ptan101/KiCad/7.0/3dmodels/Arduino_Modules/LCD TFT ILI9225 Module v4.step

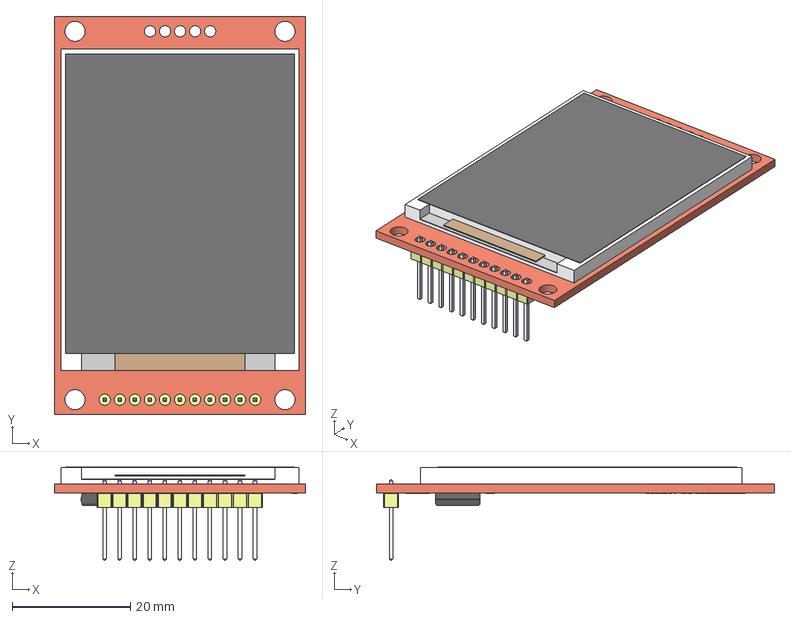
[picture p1: CAD file, 2023-09-29]
7.0/3dmodels/Arduino_Modules/LCD TFT ILI9225 Module v4.step
42.5 x 67.2 x 15.8 mm
Pin x 11
SMD IC 20 pins
Display
PCB Text
