ptan101/KiCad/7.0/3dmodels/Connectors_Custom/MOLEX_5020783310.stp

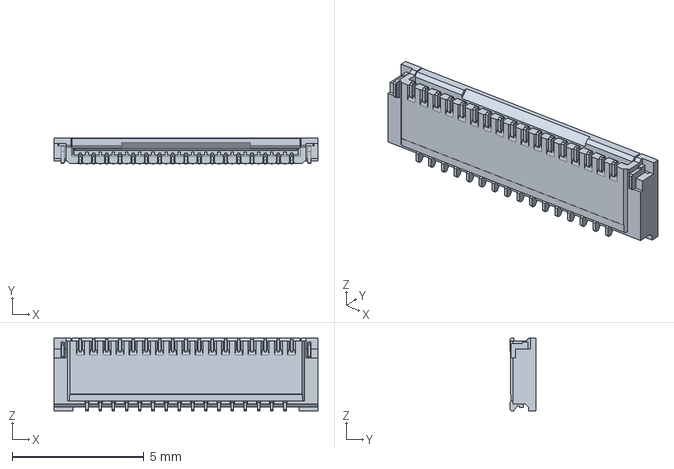
[picture p2: CAD file, 2024-09-16]
7.0/3dmodels/Connectors_Custom/MOLEX_5020783310.stp
10.0 x 1.00 x 2.75 mm
