ptan101/KiCad/7.0/3dmodels/Diode_SMD/CR_MICROSMP_DO-219AD.step

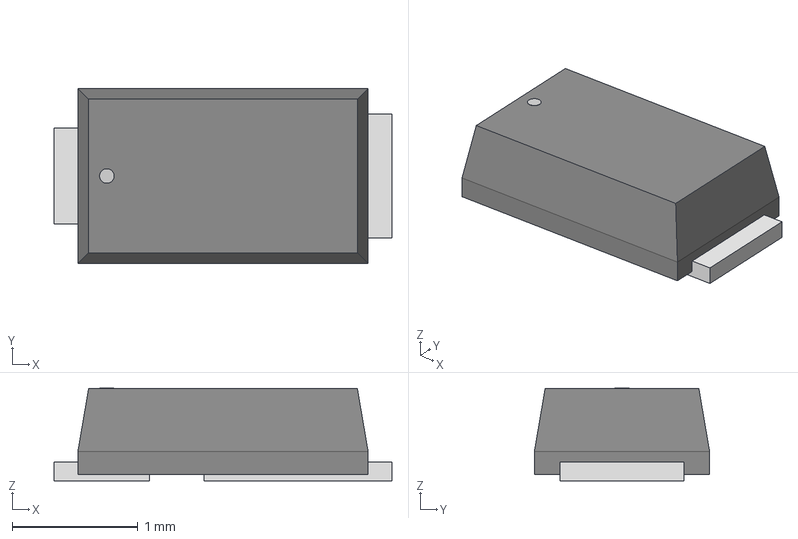
[picture p3: CAD file, 2023-09-29]
7.0/3dmodels/Diode_SMD/CR_MICROSMP_DO-219AD.step
2.69 x 1.40 x 0.739 mm
