ptan101/KiCad/7.0/3dmodels/Johanson/2450AT42A100E.STEP

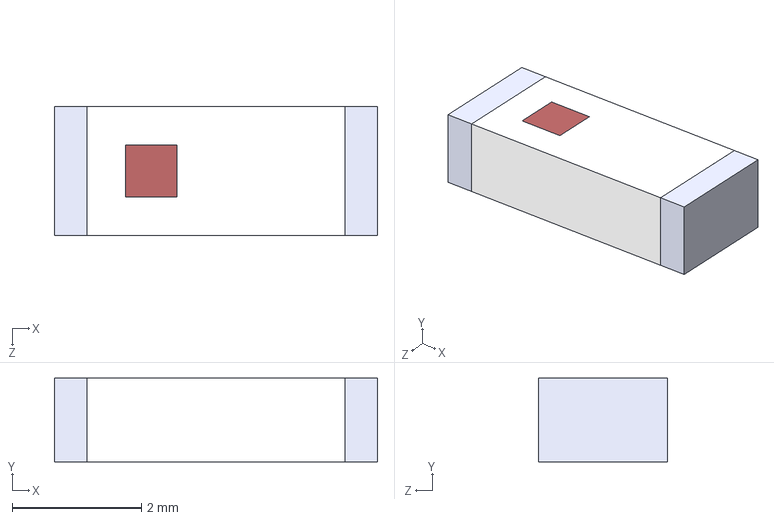
[picture p4: CAD file, 2023-09-29]
7.0/3dmodels/Johanson/2450AT42A100E.STEP
5.00 x 1.30 x 2.00 mm
