ptan101/KiCad/7.0/3dmodels/OptoDevice/Osram_SFH_4716.STEP

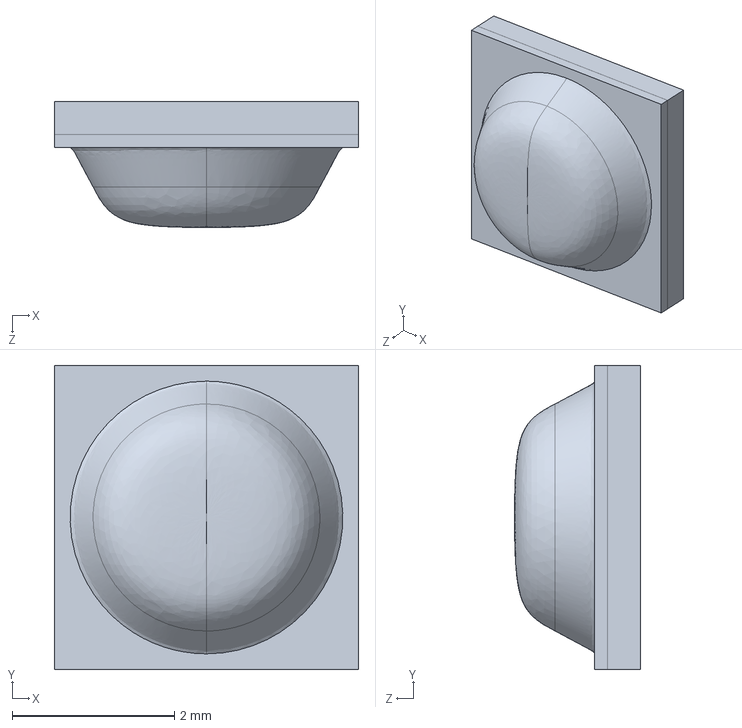
[picture p5: CAD file, 2025-01-27]
7.0/3dmodels/OptoDevice/Osram_SFH_4716.STEP
3.75 x 3.75 x 1.55 mm
