ptan101/KiCad/7.0/3dmodels/Package_BGA/DSBGA-9_1.2x1.3mm_P0.4mm.step

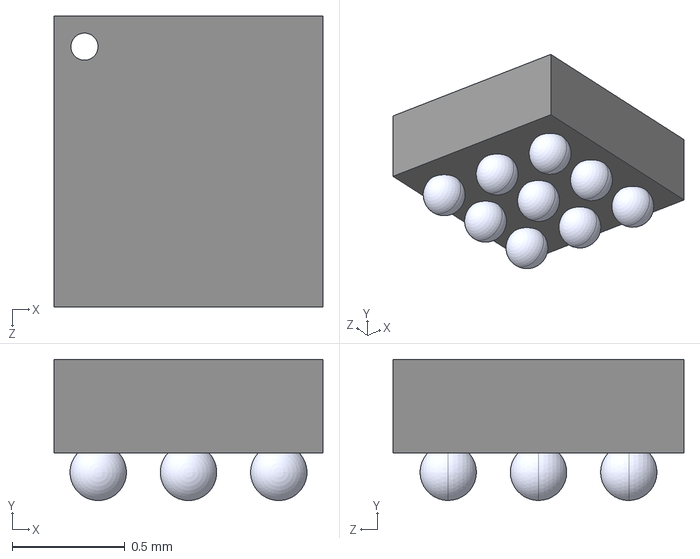
[picture p6: CAD file, 2024-09-16]
7.0/3dmodels/Package_BGA/DSBGA-9_1.2x1.3mm_P0.4mm.step
1.19 x 0.625 x 1.29 mm
