ptan101/KiCad/7.0/3dmodels/Package_CSP/UCSP-6_2.06x1.03mm_P0.5mm.step

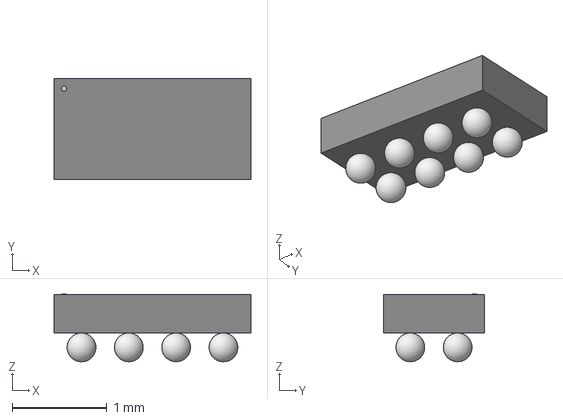
[picture p7: CAD file, 2024-01-19]
7.0/3dmodels/Package_CSP/UCSP-6_2.06x1.03mm_P0.5mm.step
2.08 x 1.07 x 0.714 mm
