ptan101/KiCad/7.0/3dmodels/Package_DFN_QFN/MCPH-6_2x1.6mm_P0.65mm.step

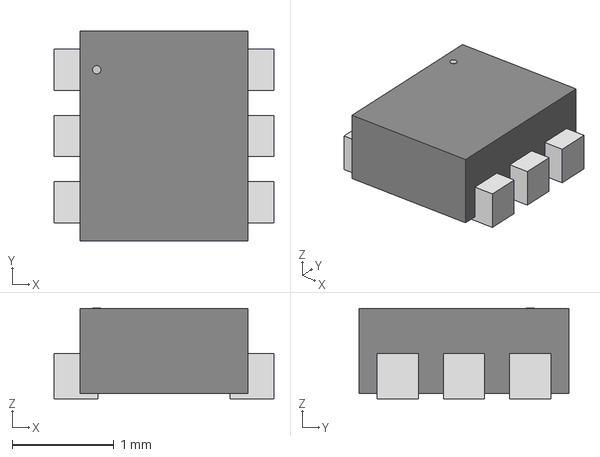
[picture p8: CAD file, 2025-01-27]
7.0/3dmodels/Package_DFN_QFN/MCPH-6_2x1.6mm_P0.65mm.step
2.16 x 2.06 x 0.892 mm
