ptan101/KiCad/7.0/3dmodels/Package_LGA/MAXM86161.STEP

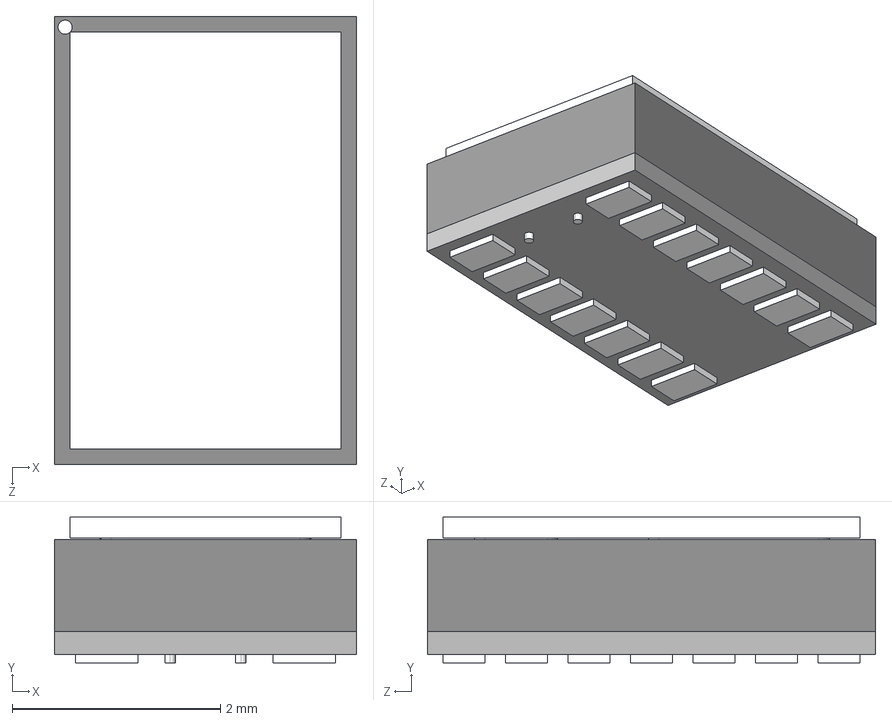
[picture p9: CAD file, 2023-09-29]
7.0/3dmodels/Package_LGA/MAXM86161.STEP
2.90 x 1.40 x 4.30 mm
