ptan101/KiCad/7.0/3dmodels/Package_SON/WSON-8-1EP_3x2mm_P0.5mm.step

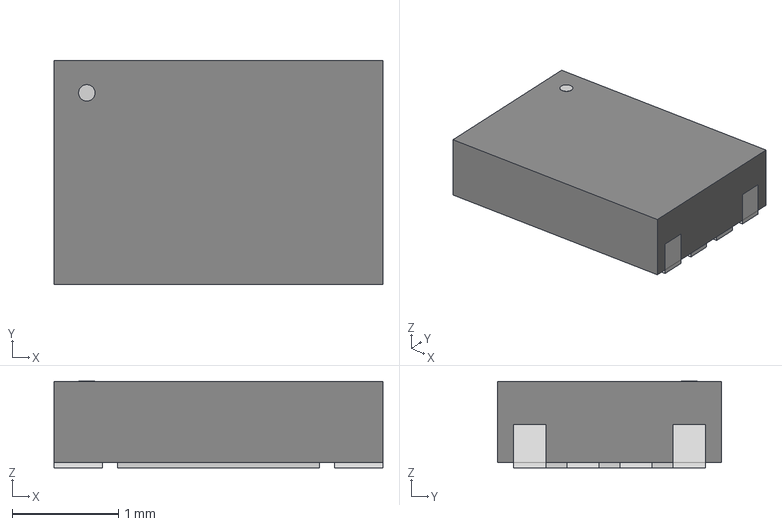
[picture p10: CAD file, 2024-09-16]
7.0/3dmodels/Package_SON/WSON-8-1EP_3x2mm_P0.5mm.step
3.10 x 2.11 x 0.815 mm
