ptan101/KiCad/7.0/3dmodels/Package_TO_SOT_SMD/SC-70_C5_MCH.step

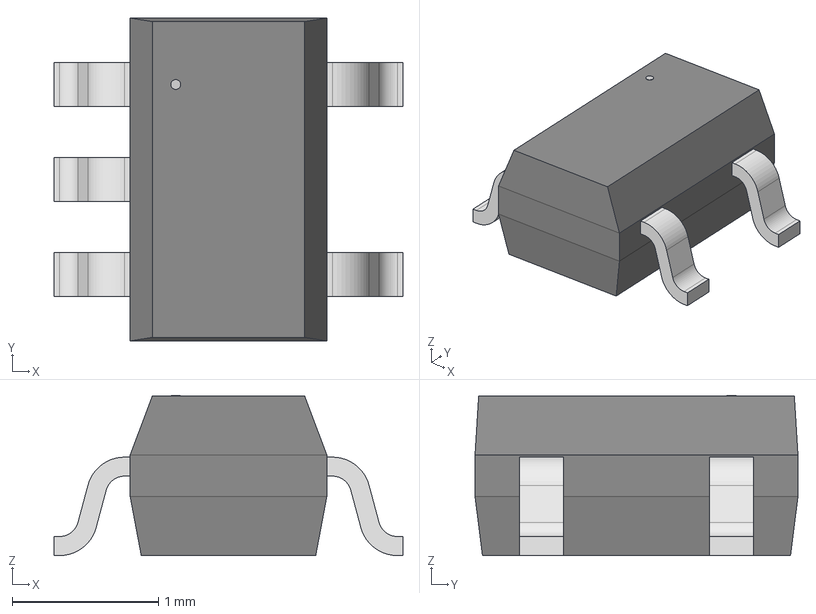
[picture p11: CAD file, 2023-09-29]
7.0/3dmodels/Package_TO_SOT_SMD/SC-70_C5_MCH.step
2.39 x 2.21 x 1.09 mm
