ptan101/KiCad/7.0/3dmodels/Arduino_Modules/Ublox GPS Module V2.0 NEO-6M v01.stp

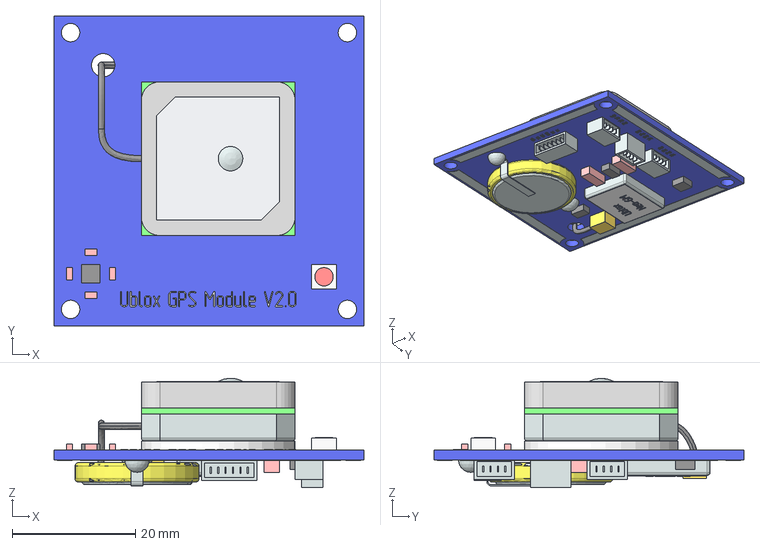
[picture p12: CAD file, 2023-09-29]
7.0/3dmodels/Arduino_Modules/Ublox GPS Module V2.0 NEO-6M v01.stp
50.4 x 50.4 x 17.8 mm
