ptan101/KiCad/7.0/3dmodels/Connectors_Custom/MOLEX_512963494.stp

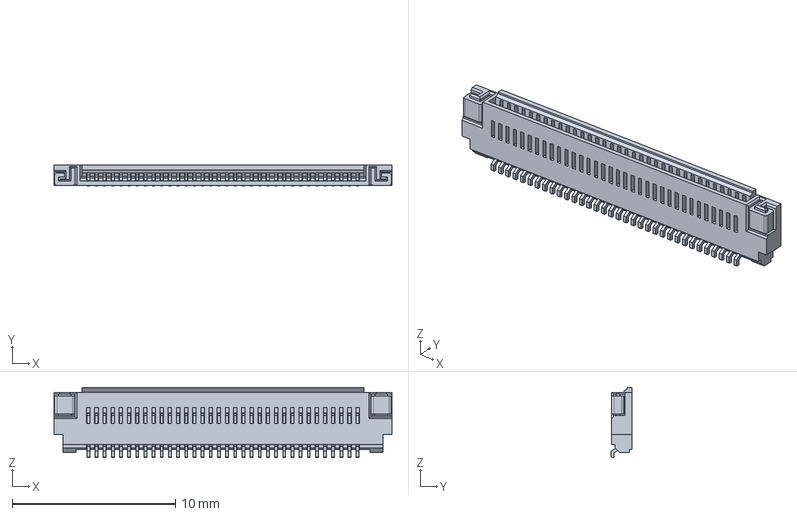
[picture p13: CAD file, 2024-09-16]
7.0/3dmodels/Connectors_Custom/MOLEX_512963494.stp
20.7 x 1.30 x 4.30 mm
