ptan101/KiCad/7.0/3dmodels/OptoDevice/Osram_SFH7016.step

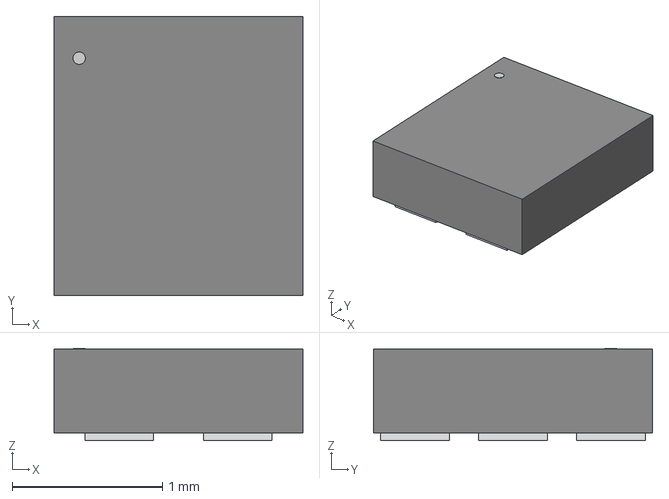
[picture p14: CAD file, 2023-09-29]
7.0/3dmodels/OptoDevice/Osram_SFH7016.step
1.65 x 1.85 x 0.612 mm
