ptan101/KiCad/7.0/3dmodels/Package_BGA/DSBGA-8_1.91x0.91mm_P0.5mm.STEP

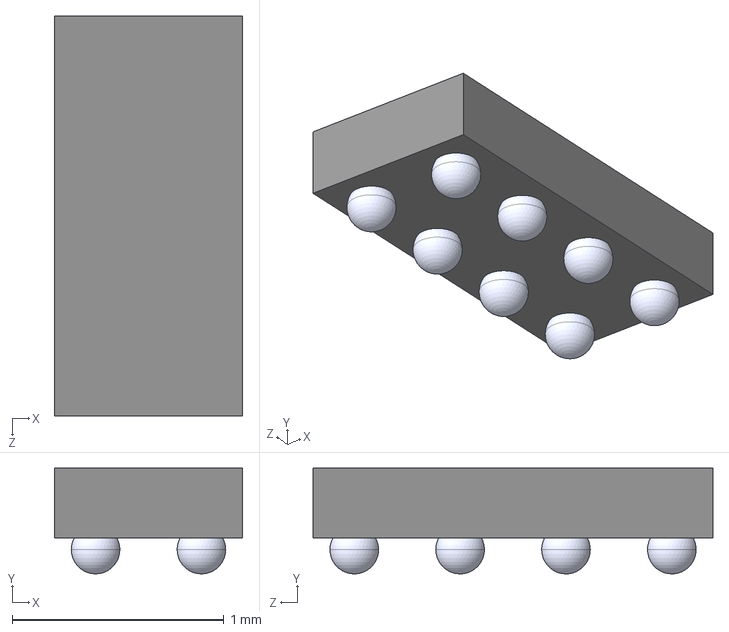
[picture p15: CAD file, 2023-09-29]
7.0/3dmodels/Package_BGA/DSBGA-8_1.91x0.91mm_P0.5mm.STEP
0.888 x 0.5 x 1.89 mm
