ptan101/KiCad/7.0/3dmodels/Package_CSP/WLCSP-50_3.0x3.2mm_P0.4mm.step

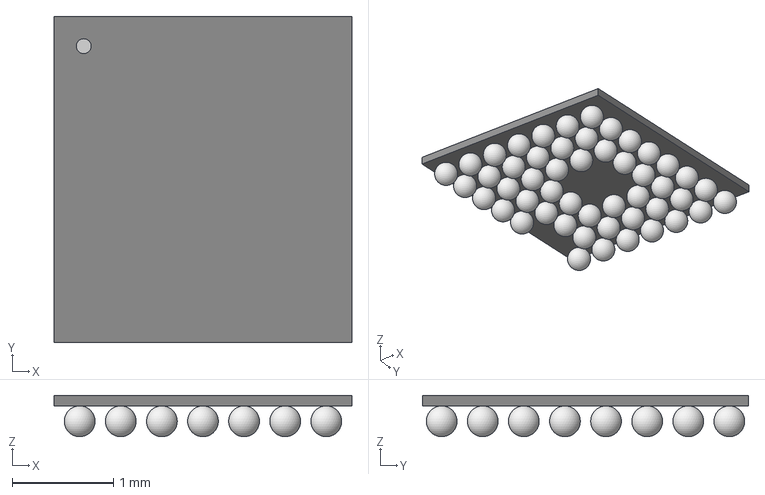
[picture p16: CAD file, 2024-01-19]
7.0/3dmodels/Package_CSP/WLCSP-50_3.0x3.2mm_P0.4mm.step
2.95 x 3.23 x 0.409 mm
