ptan101/KiCad/7.0/3dmodels/Package_DFN_QFN/C.stp

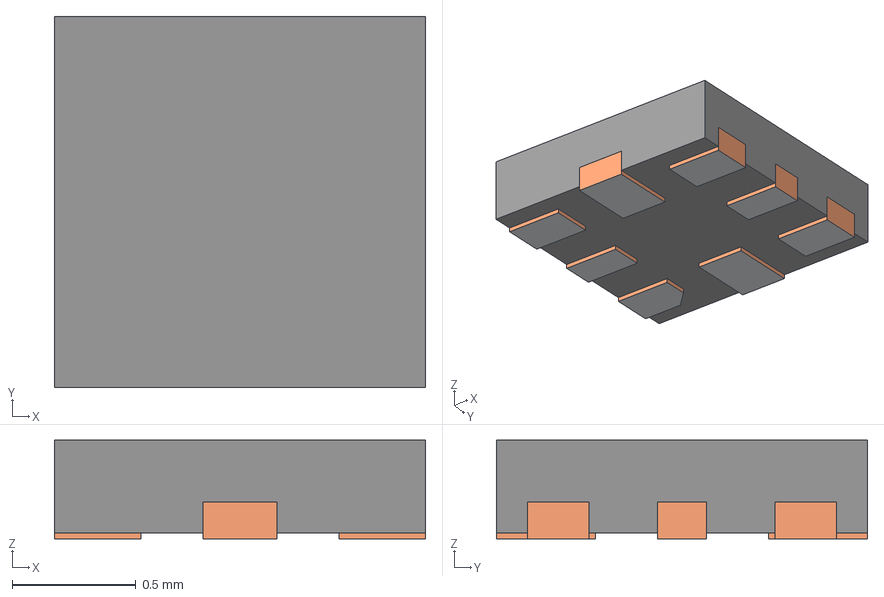
[picture p17: CAD file, 2023-10-27]
7.0/3dmodels/Package_DFN_QFN/C.stp
1.50 x 1.50 x 0.4 mm
FRAME-RUG0008A
BODY-QFN
PIN1-ID
