ptan101/KiCad/7.0/3dmodels/Package_LGA/LGA-12_2.2x2.3mm_P0.5mm.step

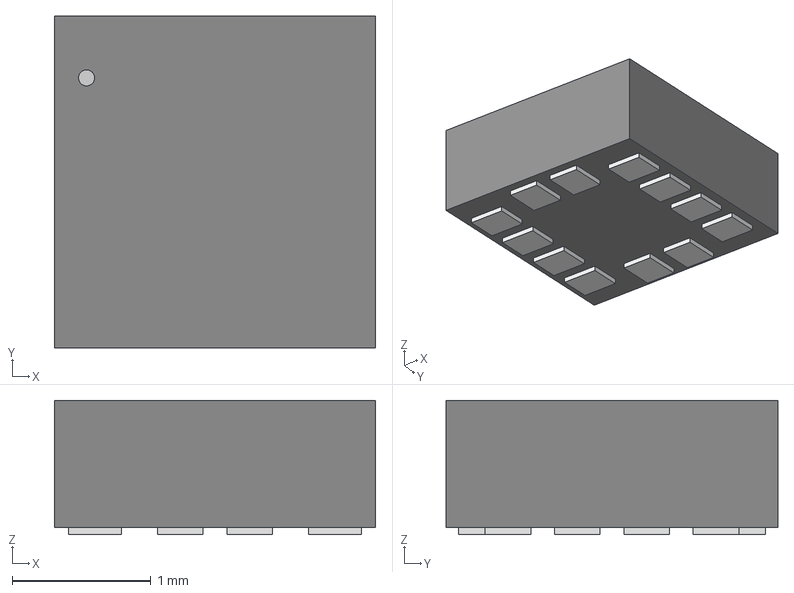
[picture p18: CAD file, 2023-09-29]
7.0/3dmodels/Package_LGA/LGA-12_2.2x2.3mm_P0.5mm.step
2.31 x 2.39 x 0.968 mm
