ptan101/KiCad/7.0/3dmodels/Package_SON/X2SON-4_0.6x0.6mm_P0.4mm.step

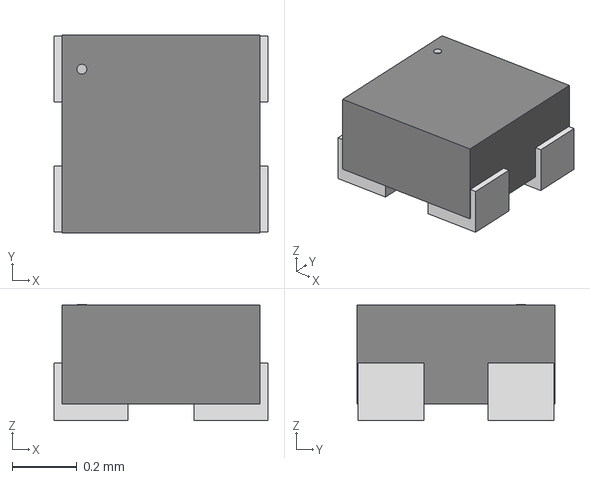
[picture p19: CAD file, 2023-09-29]
7.0/3dmodels/Package_SON/X2SON-4_0.6x0.6mm_P0.4mm.step
0.66 x 0.61 x 0.358 mm
