ptan101/KiCad/7.0/3dmodels/Connectors_Custom/MOLEX_5034801600.stp

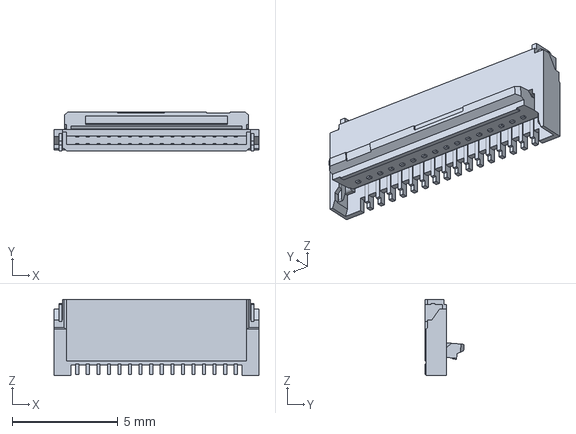
[picture p20: CAD file, 2024-03-14]
7.0/3dmodels/Connectors_Custom/MOLEX_5034801600.stp
9.70 x 1.87 x 3.60 mm
