ptan101/KiCad/7.0/3dmodels/Package_BGA/DSBGA-12_2x2mm_P0.4mm.step

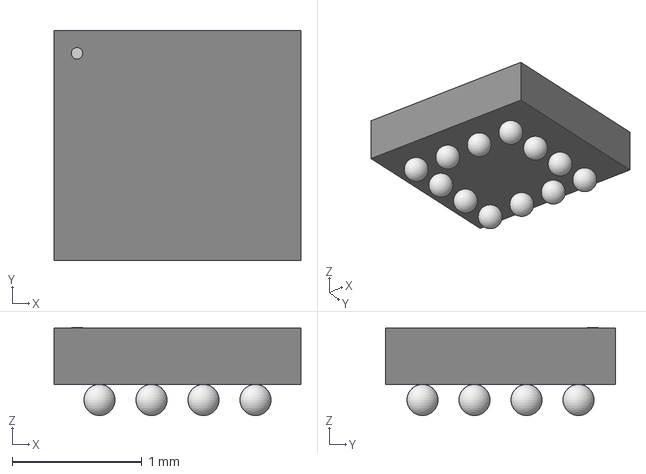
[picture p21: CAD file, 2023-09-29]
7.0/3dmodels/Package_BGA/DSBGA-12_2x2mm_P0.4mm.step
1.90 x 1.77 x 0.678 mm
