ptan101/KiCad/7.0/3dmodels/Package_CSP/WLCSP-4_1.00x1.00mm_P0.35mm.step

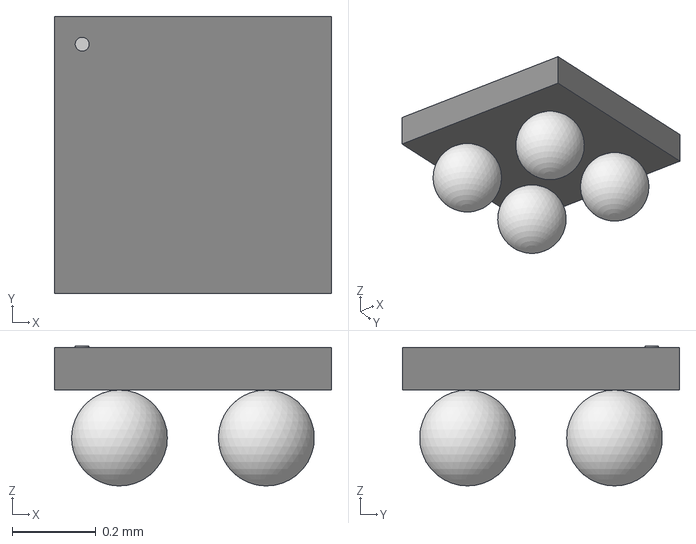
[picture p22: CAD file, 2024-01-19]
7.0/3dmodels/Package_CSP/WLCSP-4_1.00x1.00mm_P0.35mm.step
0.66 x 0.66 x 0.333 mm
