ptan101/KiCad/7.0/3dmodels/Package_LGA/MAXM86146CFU+.stp

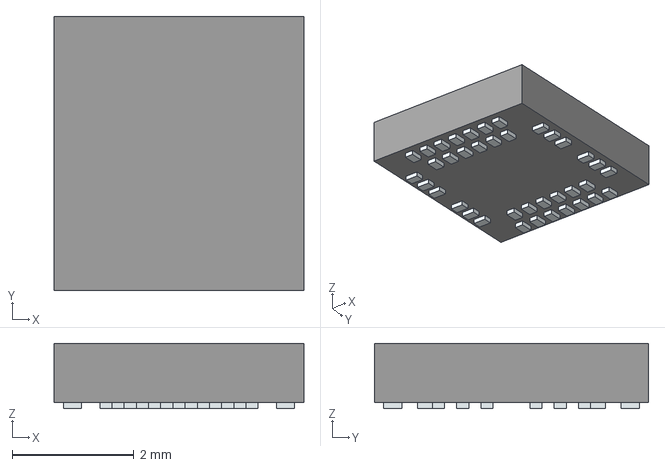
[picture p23: CAD file, 2023-09-29]
7.0/3dmodels/Package_LGA/MAXM86146CFU+.stp
4.10 x 4.50 x 1.07 mm
Pins
