ptan101/KiCad/7.0/3dmodels/Package_SON/X2SON-6_0.9x1mm_P0.3mm_SOT1115.step

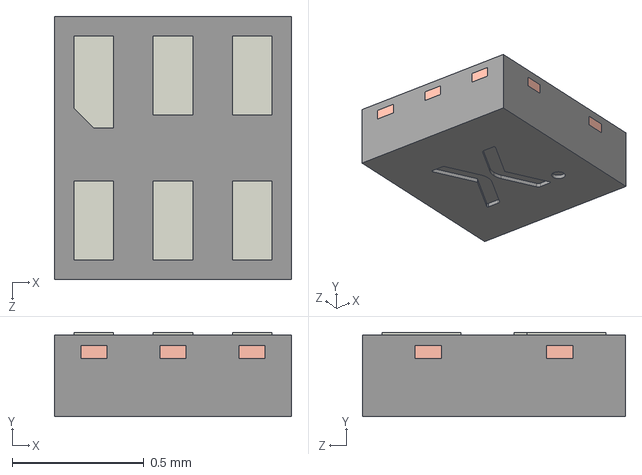
[picture p24: CAD file, 2023-09-29]
7.0/3dmodels/Package_SON/X2SON-6_0.9x1mm_P0.3mm_SOT1115.step
0.9 x 0.32 x 1.00 mm
SOT1115 LF
SOT1115 Mold body
