ptan101/KiCad/7.0/3dmodels/Connectors_Custom/MOLEX_5020781710.stp

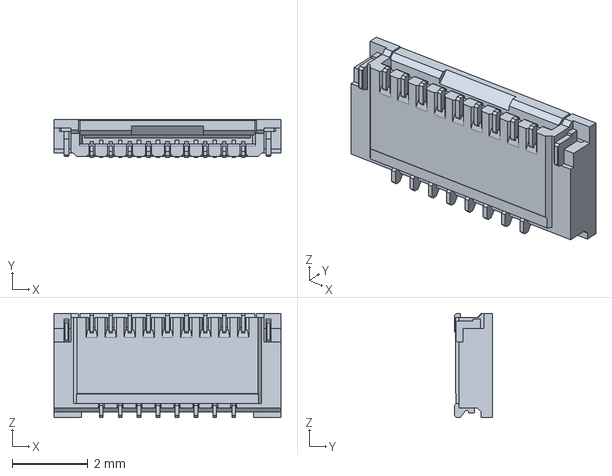
[picture p25: CAD file, 2024-03-14]
7.0/3dmodels/Connectors_Custom/MOLEX_5020781710.stp
6.00 x 1.00 x 2.75 mm
