ptan101/KiCad/7.0/3dmodels/Package_CSP/WLP-16_1.7x1.6mm_4x4_P0.3mm.step

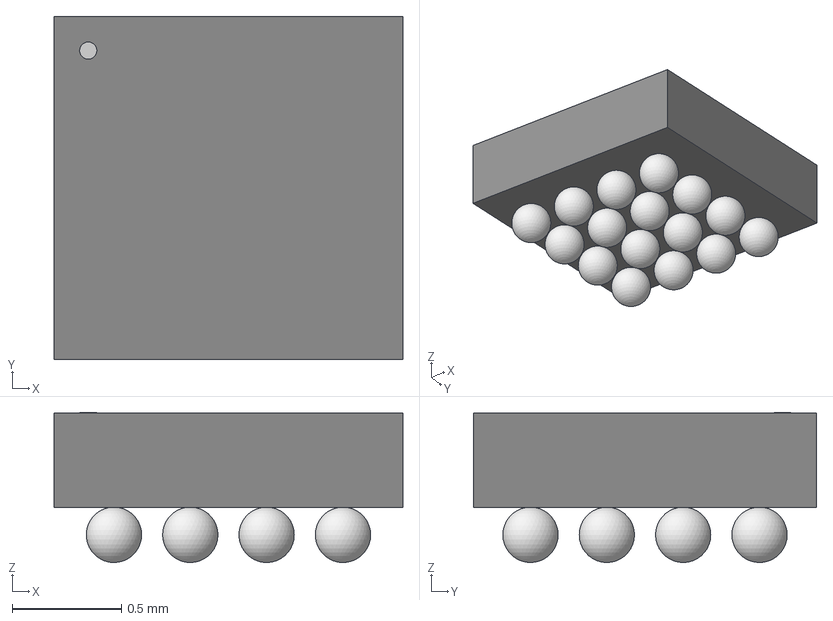
[picture p26: CAD file, 2023-09-29]
7.0/3dmodels/Package_CSP/WLP-16_1.7x1.6mm_4x4_P0.3mm.step
1.60 x 1.57 x 0.688 mm
