ptan101/KiCad/7.0/3dmodels/Package_DFN_QFN/DFN1006-2_SOD882.step

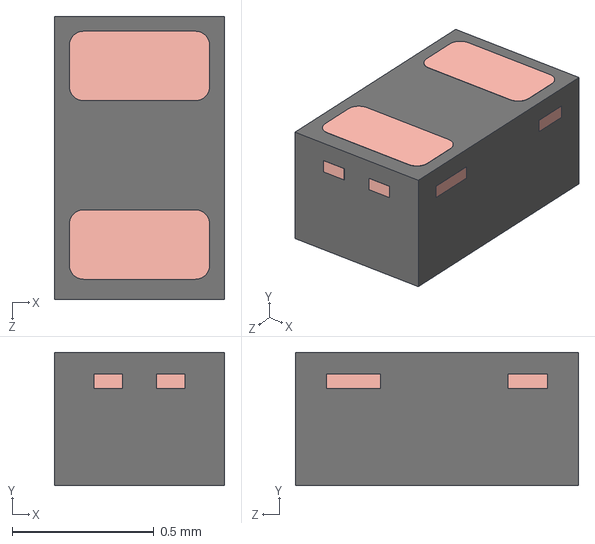
[picture p27: CAD file, 2023-09-29]
7.0/3dmodels/Package_DFN_QFN/DFN1006-2_SOD882.step
0.6 x 0.471 x 1.00 mm
SOD882 body
SOD882A3 singulated LF unit
