ptan101/KiCad/7.0/3dmodels/Connectors_Custom/MOLEX_5034800800.stp

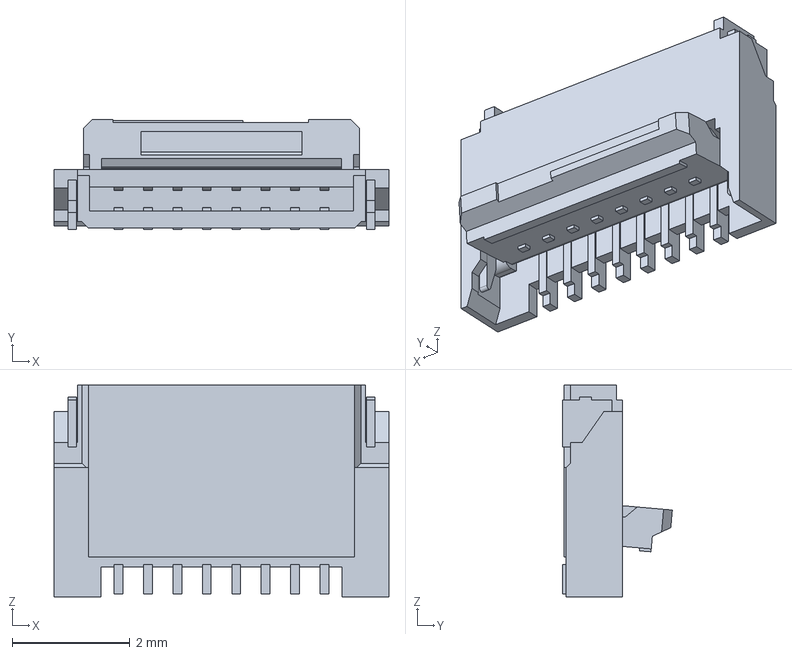
[picture p28: CAD file, 2024-01-19]
7.0/3dmodels/Connectors_Custom/MOLEX_5034800800.stp
5.70 x 1.87 x 3.60 mm
