ptan101/KiCad/7.0/3dmodels/Package_BGA/DSBGA-8_1.25x2.25mm_P0.5mm.step

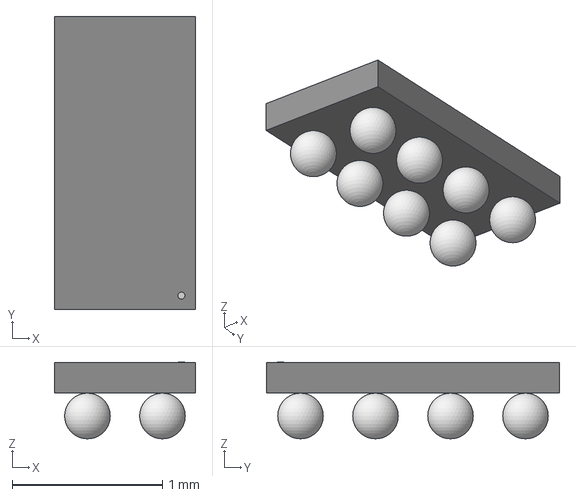
[picture p29: CAD file, 2023-09-29]
7.0/3dmodels/Package_BGA/DSBGA-8_1.25x2.25mm_P0.5mm.step
0.94 x 1.96 x 0.511 mm
