ptan101/KiCad/7.0/3dmodels/Package_CSP/WLP_2.048x1.848mm_4x5_P0.4mm.step

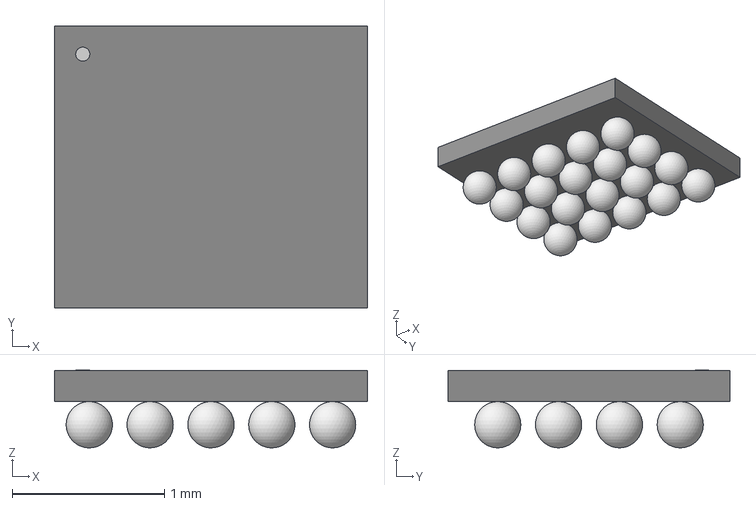
[picture p30: CAD file, 2023-09-29]
7.0/3dmodels/Package_CSP/WLP_2.048x1.848mm_4x5_P0.4mm.step
2.06 x 1.85 x 0.511 mm
