ptan101/KiCad/7.0/3dmodels/Package_DFN_QFN/QFN-12-1EP_4x4mm_P0.8mm_EP1.7x1.7mm.step

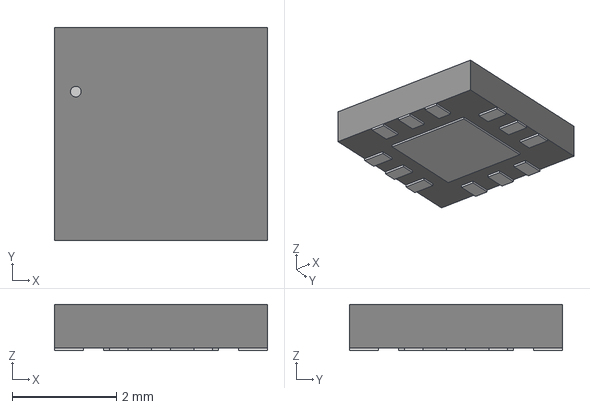
[picture p31: CAD file, 2023-09-29]
7.0/3dmodels/Package_DFN_QFN/QFN-12-1EP_4x4mm_P0.8mm_EP1.7x1.7mm.step
4.09 x 4.09 x 0.892 mm
