ptan101/KiCad/7.0/3dmodels/Package_SON/X2SON-6_1x0.8mm.STEP

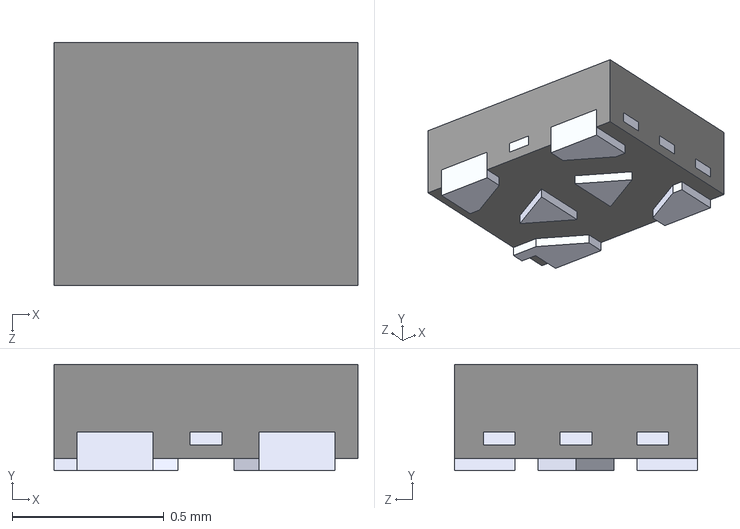
[picture p32: CAD file, 2023-09-29]
7.0/3dmodels/Package_SON/X2SON-6_1x0.8mm.STEP
1.00 x 0.35 x 0.8 mm
