ptan101/KiCad/7.0/3dmodels/Package_BGA/SiT_1.5x0.8mm.STEP

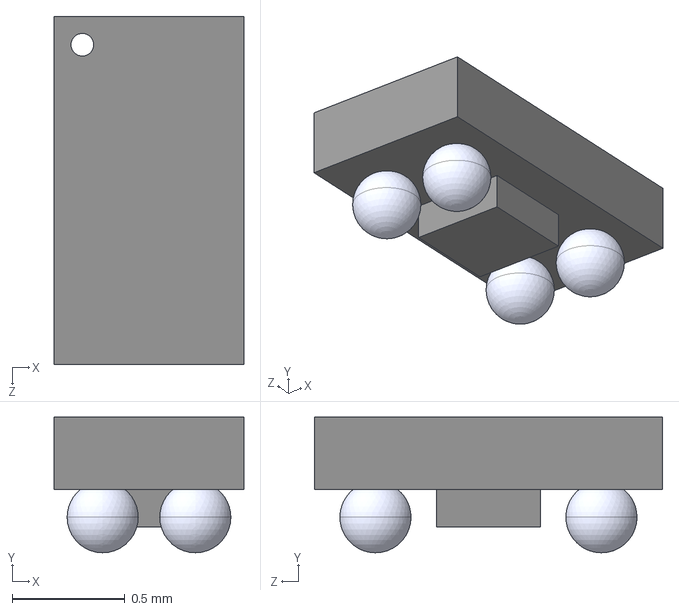
[picture p33: CAD file, 2023-09-29]
7.0/3dmodels/Package_BGA/SiT_1.5x0.8mm.STEP
0.84 x 0.6 x 1.54 mm
