ptan101/KiCad/7.0/3dmodels/Package_DFN_QFN/DHVQFN-16_2.5x3.5mm_P0.5mm.step

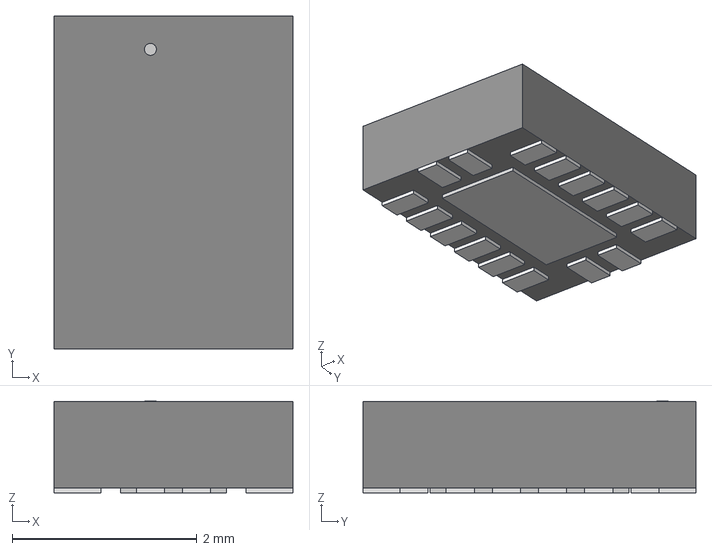
[picture p34: CAD file, 2023-09-29]
7.0/3dmodels/Package_DFN_QFN/DHVQFN-16_2.5x3.5mm_P0.5mm.step
2.59 x 3.61 x 0.993 mm
