ptan101/KiCad/7.0/3dmodels/Package_SON/X2SON-10_2x1.5mm_P0.5mm.stp

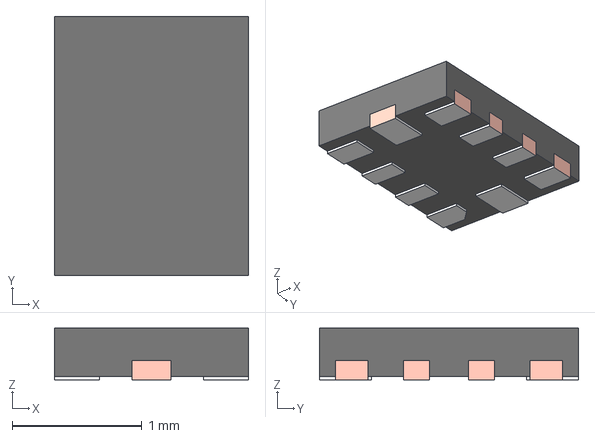
[picture p35: CAD file, 2023-09-29]
7.0/3dmodels/Package_SON/X2SON-10_2x1.5mm_P0.5mm.stp
1.50 x 2.00 x 0.4 mm
FRAME_RUG0010A
BODY_RUG0010A
