ptan101/KiCad/7.0/3dmodels/Package_CSP/WLP-28_2.78x1.71mm_P0.35mm.step

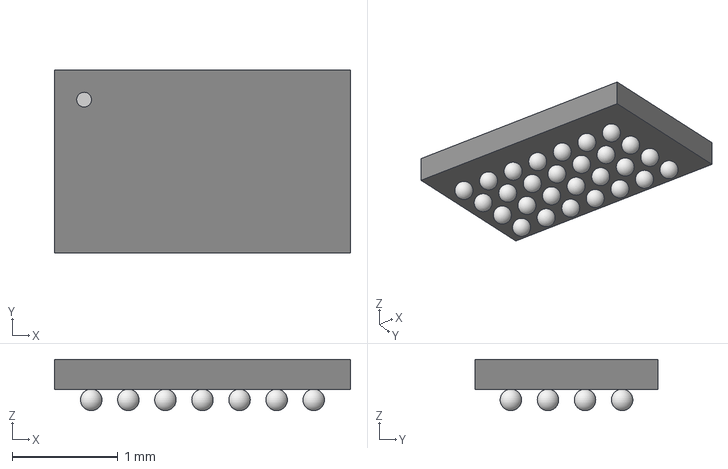
[picture p36: CAD file, 2023-09-29]
7.0/3dmodels/Package_CSP/WLP-28_2.78x1.71mm_P0.35mm.step
2.79 x 1.73 x 0.485 mm
