ptan101/KiCad/7.0/3dmodels/Package_DFN_QFN/X1QFN-1EP_2x2mm_P0.4mm_EP1.2x1.2mm.stp

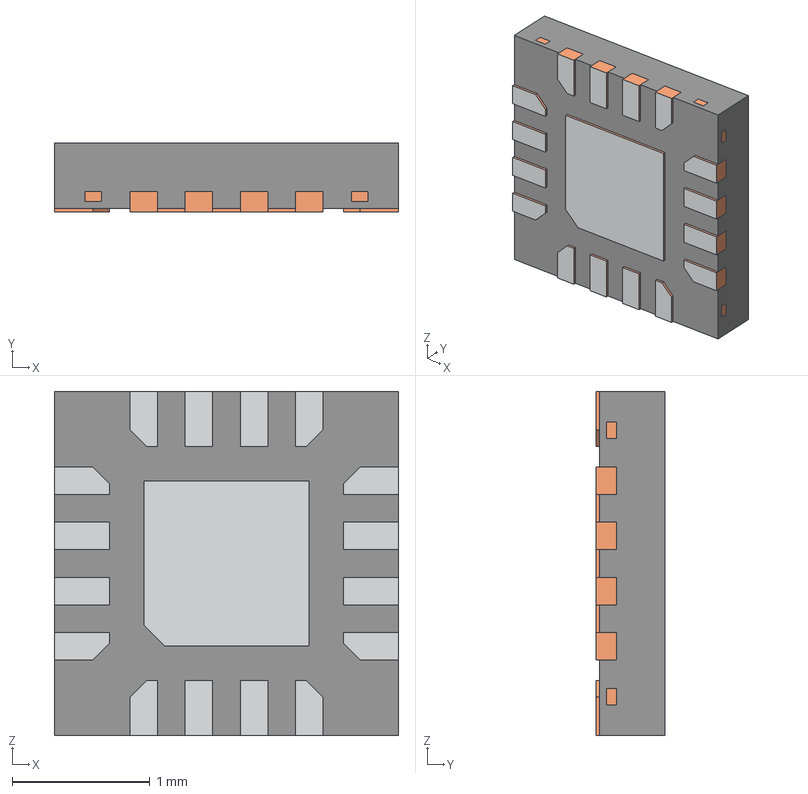
[picture p37: CAD file, 2023-09-29]
7.0/3dmodels/Package_DFN_QFN/X1QFN-1EP_2x2mm_P0.4mm_EP1.2x1.2mm.stp
2.50 x 0.5 x 2.50 mm
BODY-QFN
FRAME-RWN0016A
PIN1-ID
