ptan101/KiCad/7.0/3dmodels/Package_SON/X2SON-8_1x1.4mm_P0.35mm.stp

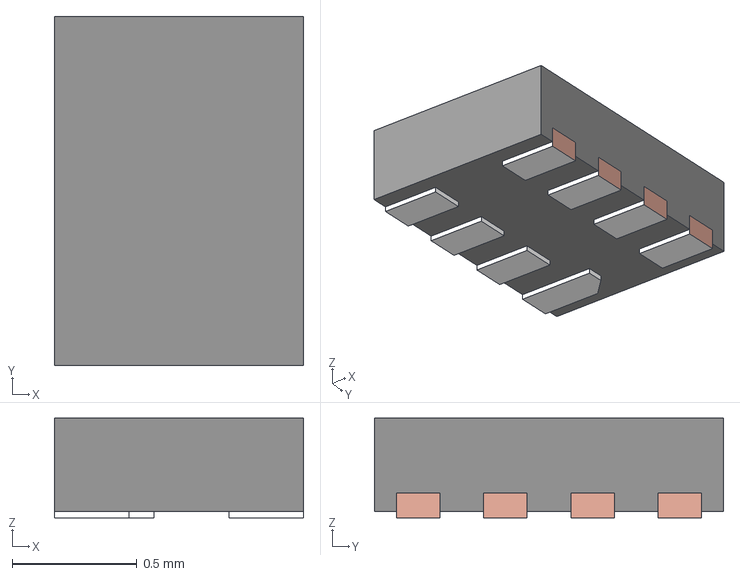
[picture p38: CAD file, 2023-09-29]
7.0/3dmodels/Package_SON/X2SON-8_1x1.4mm_P0.35mm.stp
1.00 x 1.40 x 0.4 mm
BODY-SON1
FRAME-DQE0008A
