ptan101/KiCad/7.0/3dmodels/Package_CSP/WLCSP-16_1.4x2.46mm_P0.4mm.step

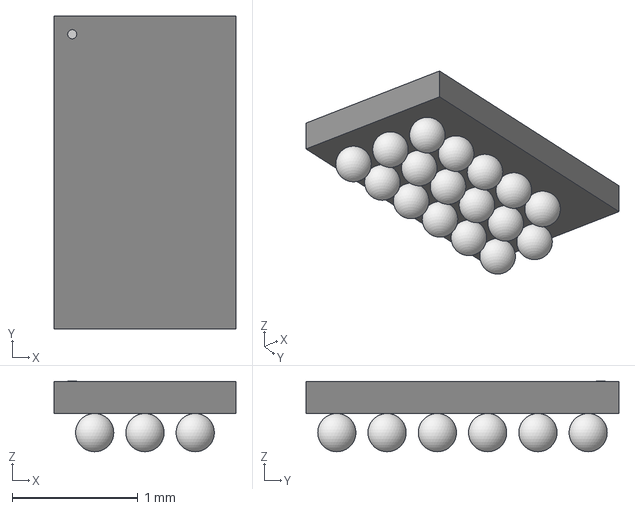
[picture p39: CAD file, 2023-09-29]
7.0/3dmodels/Package_CSP/WLCSP-16_1.4x2.46mm_P0.4mm.step
1.45 x 2.49 x 0.561 mm
