ptan101/KiCad/7.0/3dmodels/Package_DFN_QFN/Texas_RUC_X2QFN14_2x2mm.stp

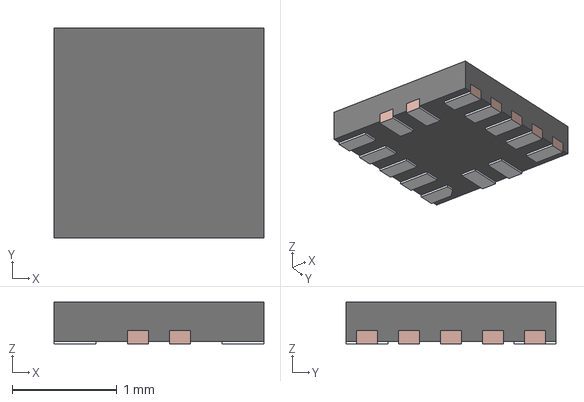
[picture p40: CAD file, 2023-09-29]
7.0/3dmodels/Package_DFN_QFN/Texas_RUC_X2QFN14_2x2mm.stp
2.00 x 2.00 x 0.4 mm
FRAME
