ptan101/KiCad/7.0/3dmodels/Package_SON/X2SON-6_1x1mm_P0.35mm_DSF.stp

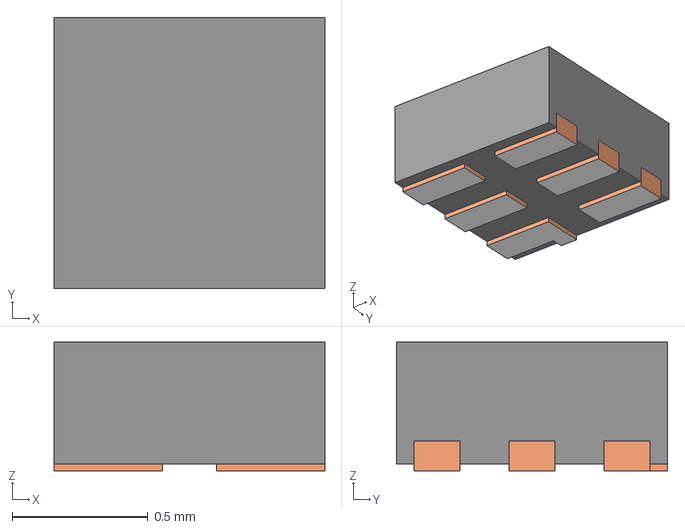
[picture p41: CAD file, 2023-09-29]
7.0/3dmodels/Package_SON/X2SON-6_1x1mm_P0.35mm_DSF.stp
1.00 x 1.00 x 0.475 mm
BODY-SON
FRAME-DSF0006A
