ptan101/KiCad/7.0/3dmodels/Package_CSP/WLP-6_1.1x0.73mm_P0.35mm.step

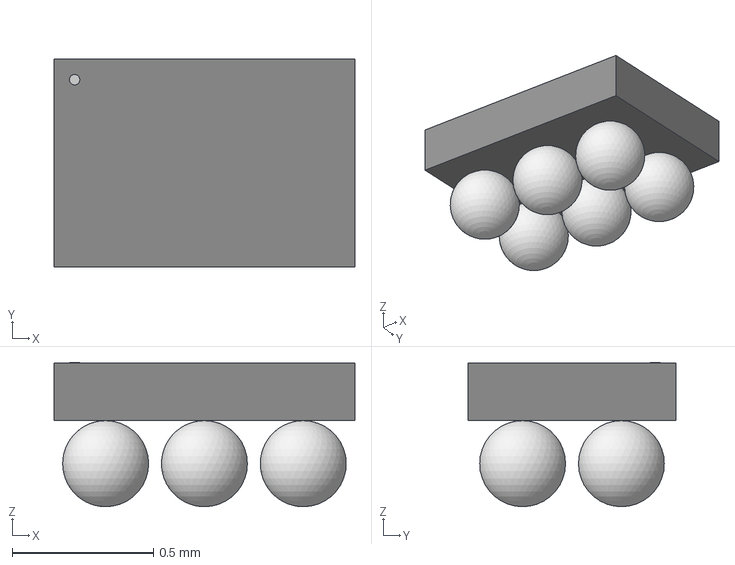
[picture p42: CAD file, 2023-09-29]
7.0/3dmodels/Package_CSP/WLP-6_1.1x0.73mm_P0.35mm.step
1.07 x 0.736 x 0.511 mm
