ptan101/KiCad/7.0/3dmodels/Package_DFN_QFN/UDFN-8_2x2mm_P0.5mm.step

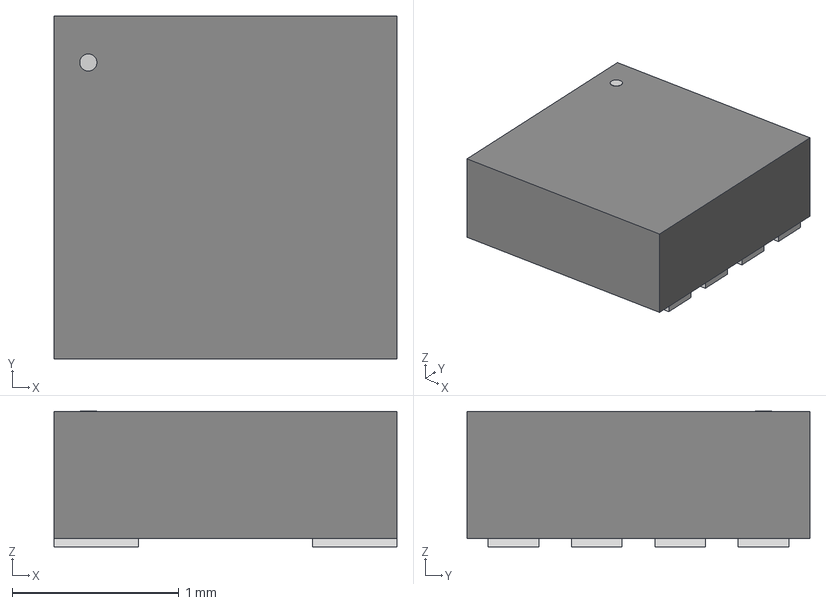
[picture p43: CAD file, 2023-09-29]
7.0/3dmodels/Package_DFN_QFN/UDFN-8_2x2mm_P0.5mm.step
2.06 x 2.06 x 0.815 mm
