ptan101/KiCad/7.0/3dmodels/Package_SON/X2SON-8_1.35_0.8mm_P0.5mm.STEP

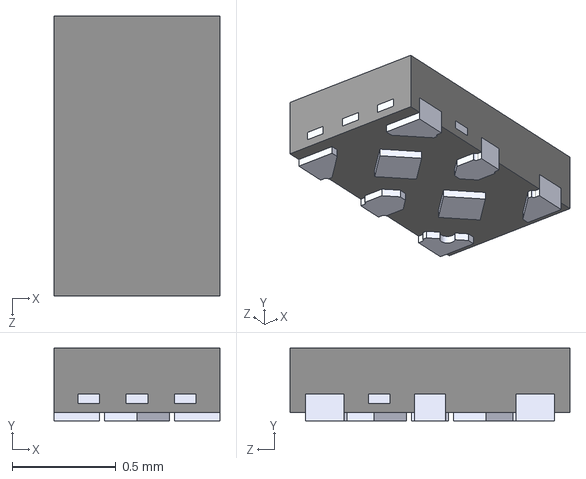
[picture p44: CAD file, 2023-09-29]
7.0/3dmodels/Package_SON/X2SON-8_1.35_0.8mm_P0.5mm.STEP
0.8 x 0.35 x 1.35 mm
