ptan101/KiCad/7.0/3dmodels/Package_CSP/WLCSP-35_3.11x2.14mm_P0.4mm.step

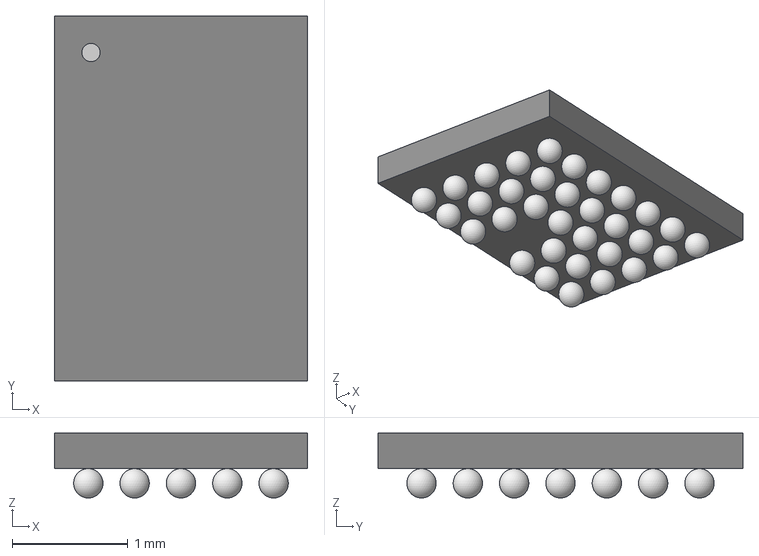
[picture p45: CAD file, 2023-09-29]
7.0/3dmodels/Package_CSP/WLCSP-35_3.11x2.14mm_P0.4mm.step
2.18 x 3.15 x 0.561 mm
