ptan101/KiCad/7.0/3dmodels/Package_DFN_QFN/TDFN-8-1EP_3x3mm.STEP

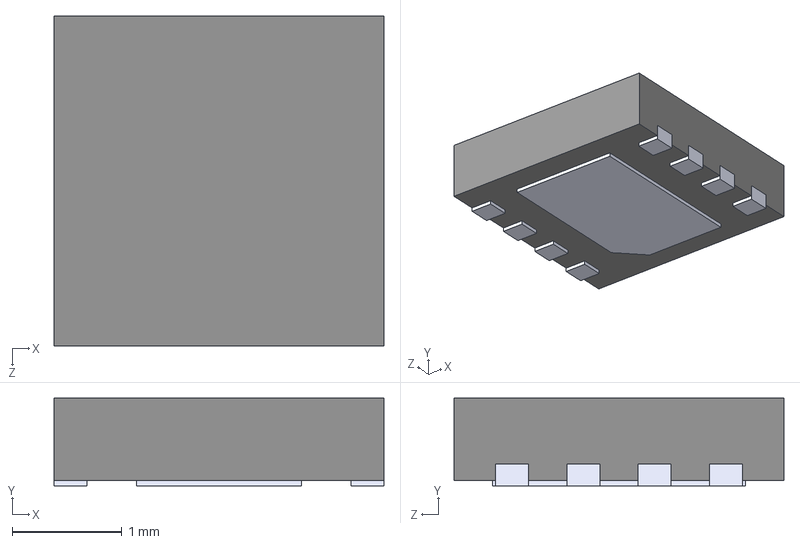
[picture p46: CAD file, 2023-09-29]
7.0/3dmodels/Package_DFN_QFN/TDFN-8-1EP_3x3mm.STEP
3.00 x 0.8 x 3.00 mm
