ptan101/KiCad/7.0/3dmodels/Package_DFN_QFN/XDFN-4-1EP_1x1mm.STEP

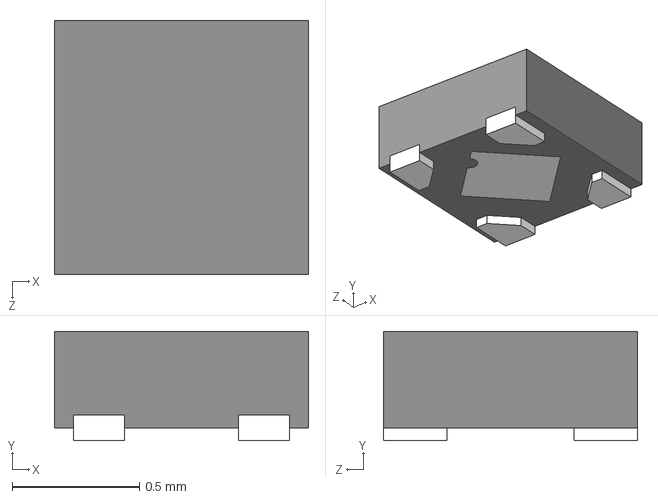
[picture p47: CAD file, 2023-09-29]
7.0/3dmodels/Package_DFN_QFN/XDFN-4-1EP_1x1mm.STEP
1.00 x 0.43 x 1.00 mm
