ptan101/KiCad/7.0/3dmodels/Package_DFN_QFN/UQFN-10_2x1.5mm_P0.5mm_RSE.step

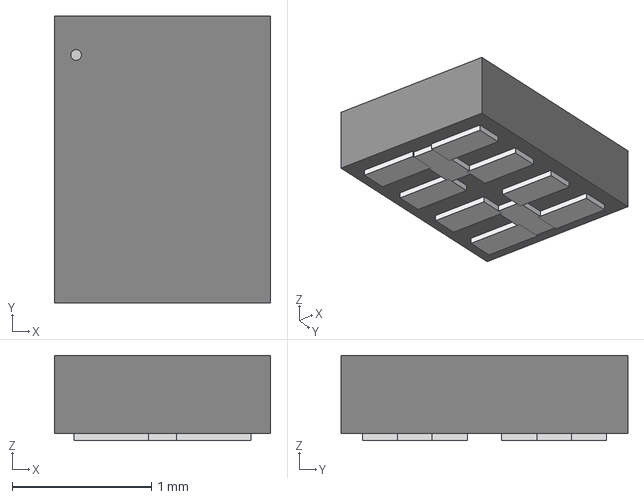
[picture p48: CAD file, 2023-09-29]
7.0/3dmodels/Package_DFN_QFN/UQFN-10_2x1.5mm_P0.5mm_RSE.step
1.55 x 2.06 x 0.612 mm
