ptan101/KiCad/7.0/3dmodels/Package_DFN_QFN/DFN1006-3_1x0.6mm.step

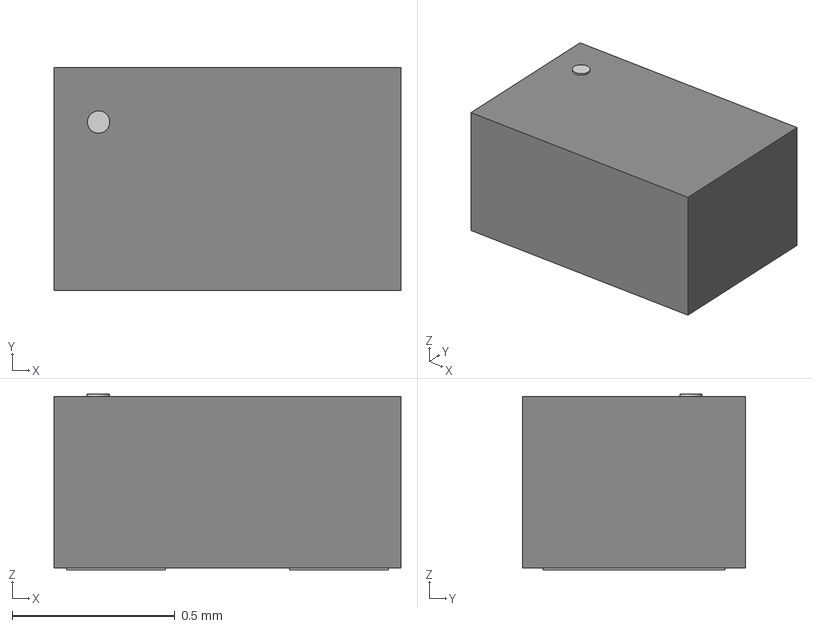
[picture p49: CAD file, 2023-09-29]
7.0/3dmodels/Package_DFN_QFN/DFN1006-3_1x0.6mm.step
1.07 x 0.686 x 0.54 mm
