ptan101/KiCad/7.0/3dmodels/Package_DFN_QFN/DFN-8-2EP_4x4mm_P1.0mm_EP1.45x1.45mm.step

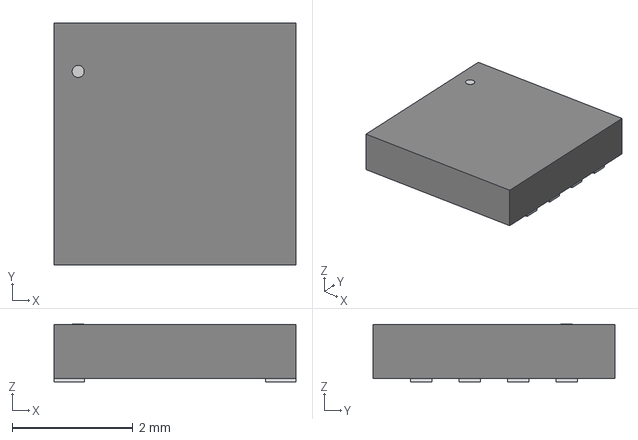
[picture p50: CAD file, 2023-09-29]
7.0/3dmodels/Package_DFN_QFN/DFN-8-2EP_4x4mm_P1.0mm_EP1.45x1.45mm.step
4.00 x 4.00 x 0.952 mm
