ptan101/KiCad/7.0/3dmodels/Package_DFN_QFN/DFN-18-1EP_5x5mm_P0.5mm_EP3.65x4.35mm.step

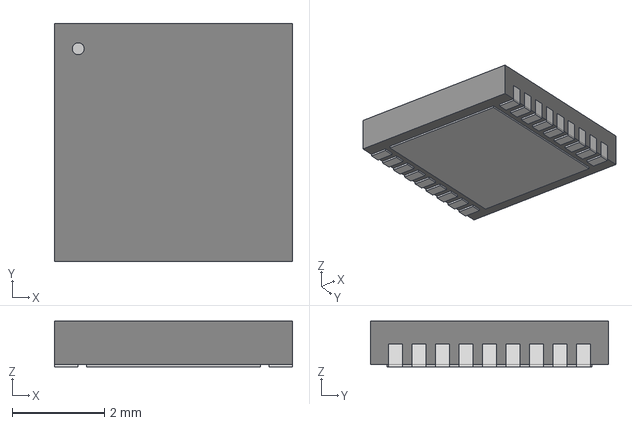
[picture p51: CAD file, 2023-09-29]
7.0/3dmodels/Package_DFN_QFN/DFN-18-1EP_5x5mm_P0.5mm_EP3.65x4.35mm.step
5.16 x 5.16 x 0.993 mm
