ptan101/KiCad/7.0/3dmodels/Package_DFN_QFN/UQFN-16_2.6x1.8mm_P0.4mm.stp

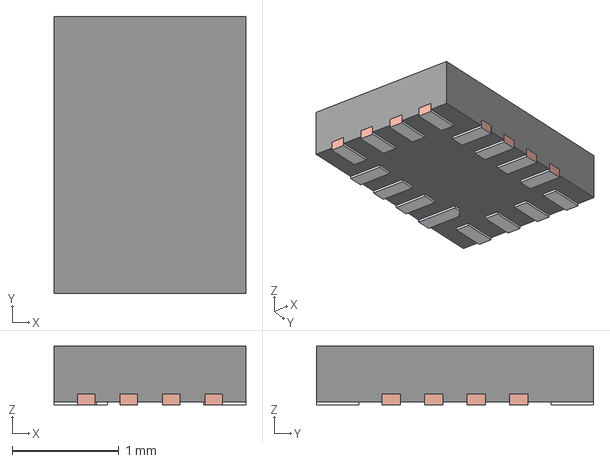
[picture p52: CAD file, 2023-09-29]
7.0/3dmodels/Package_DFN_QFN/UQFN-16_2.6x1.8mm_P0.4mm.stp
1.80 x 2.60 x 0.55 mm
BODY-SON1
FRAME-RSV0016A
