ptan101/KiCad/7.0/3dmodels/Package_DFN_QFN/DHVQFN-14_3x2.5mm.step

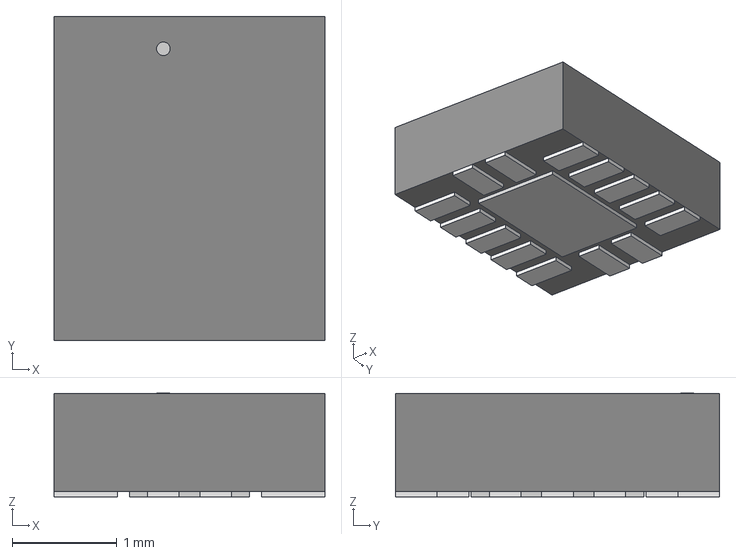
[picture p53: CAD file, 2023-09-29]
7.0/3dmodels/Package_DFN_QFN/DHVQFN-14_3x2.5mm.step
2.59 x 3.10 x 0.993 mm
