ptan101/KiCad/7.0/3dmodels/Package_DFN_QFN/UQFN-10_2x2mm_P0.5mm.stp

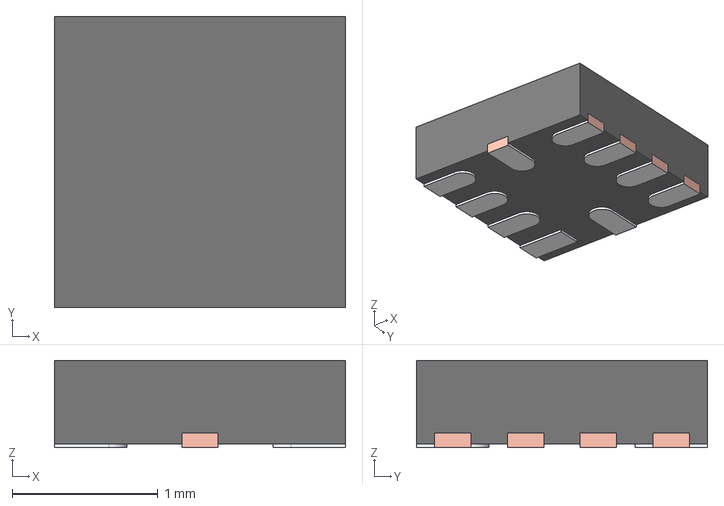
[picture p54: CAD file, 2023-09-27]
7.0/3dmodels/Package_DFN_QFN/UQFN-10_2x2mm_P0.5mm.stp
2.00 x 2.00 x 0.6 mm
FRAME
MOLD
