ptan101/KiCad/7.0/3dmodels/Package_DFN_QFN/UQFN-14_2.5x2.5mm_P0.4mm.stp

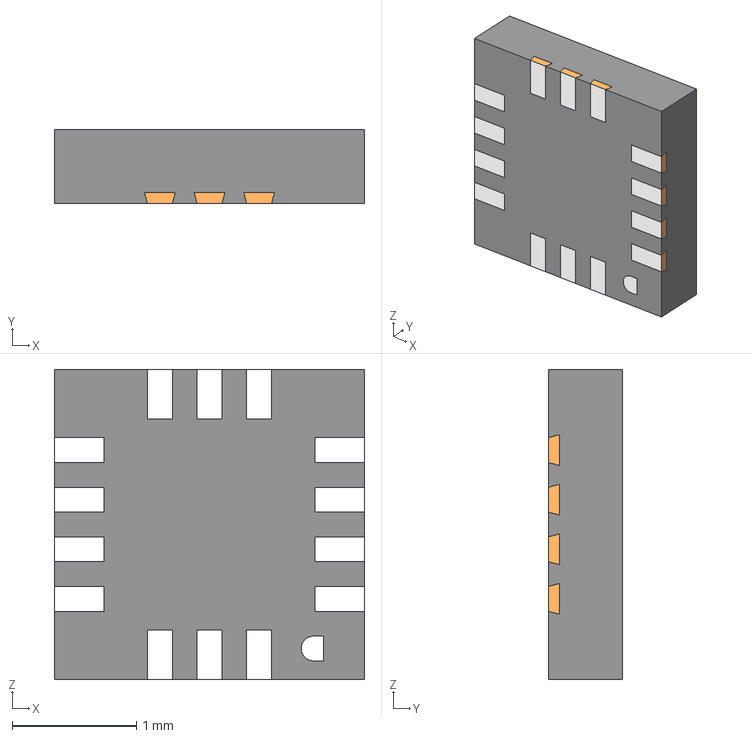
[picture p55: CAD file, 2023-09-27]
7.0/3dmodels/Package_DFN_QFN/UQFN-14_2.5x2.5mm_P0.4mm.stp
2.50 x 0.6 x 2.50 mm
FRAME_LEE14A
BODY_LEE14A
