ptan101/KiCad/(list of files, cad)

Other CAD files:
7.0/3dmodels/Package_CSP/WLCSP-33_2.5x2.5mm_P0.4mm.step
