ptan101/KiCad/(commit log)

2023-09-27 New footprints and stuff
    idk
    [UQFN-10_2x2mm_P0.5mm.stp, UQFN-14_2.5x2.5mm_P0.4mm.stp]
2023-09-29 Some 3D models and TI symbol descriptions
    [2450AT42A100E.STEP, Battery_LIR1254.STEP, CR_MICROSMP_DO-219AD.step, DFN-18-1EP_5x5mm_P0.5mm_EP3.65x4.35mm.step, DFN-8-2EP_4x4mm_P1.0mm_EP1.45x1.45mm.step, DFN1006-2_SOD882.step, DFN1006-3_1x0.6mm.step, DHVQFN-14_3x2.5mm.step]
2024-01-19 idk
    fixed 3d models for csp
    [KiCAD_Custom_DRC_Rules_for_PCBWay.kicad_pcb, KiCAD_Custom_DRC_Rules_for_PCBWay.kicad_sch, MOLEX_5034800800.stp, UCSP-6_2.06x1.03mm_P0.5mm.step, WLCSP-16_1.4x2.46mm_P0.4mm.step, WLCSP-33_2.5x2.5mm_P0.4mm.step, WLCSP-35_3.11x2.14mm_P0.4mm.step, WLCSP-4_1.00x1.00mm_P0.35mm.step]
2024-03-14 45ewerys
    yesyreyeqewtw435y4wth
    [MOLEX_5020781710.stp, MOLEX_5034801600.stp]
2024-09-16 dfsSDFS
    dfsfdsf
    [DSBGA-9_1.2x1.3mm_P0.4mm.step, MOLEX_5020783310.stp, MOLEX_512963494.stp, WSON-8-1EP_3x2mm_P0.5mm.step]
